terence304/eeg/README.md

# This is a EEG(electroencephalogram) project of Altium Designer PCB layout
