terence304/eeg/Documentation/BOM.xlsx

Sheet: Part List Report
 | Component list |  |  |  | Bill of Materials For PCB Document [PCB3.PcbDoc]
 | Source Data From: | PCB3.PcbDoc |  |  |  | Contact:
 | Project: | Final_Project_Layout.PrjPcb |  |  |  | NYU
 | Variant: | None |  | Chung-Ying Huang | cyh316@nyu.edu | Your group number : 19
 |  |  |  | Yu-Yang Lin | yyl289@nyu.edu | your email
 | Report Date: | 11/10/2014 | 2:04:17 PM
 | Print Date: | 2014-11-10 | 16:44:28
# | #Column Name Error:Category | Designator | #Column Name Error:Manufacturer | #Column Name Error:Manufacturer Part Number | #Column Name Error:Package / Case | LibRef | Quantity | #Column Name Error:Supplier 1 | #Column Name Error:Supplier Part Number 1 | #Column Name Error:Supplier Order Qty 1 | #Column Name Error:Supplier Stock 1 | #Column Name Error:Supplier Unit Price 1 | #Column Name Error:Supplier Subtotal 1 | #Column Name Error:Supplier Currency 1
1 |  | B1 |  |  |  | BatteryHolder_CR123A | 1
 |  | c1,c3,c4,c12,c17 |  |  |  | 2.2u, Capacitor | 5
 |  | c2,c5,c6,c7,c10,c11,c13,c16 |  |  |  | 0.1u, Capacitor | 8
 |  | c8 |  |  |  | 470p, Capacitor | 1
 |  | c9,c18 |  |  |  | 10u, Capacitor | 2
 |  | c14 |  |  |  | 10n, Capacitor | 1
 |  | c15,c19 |  |  |  | 2.2n, Capacitor | 2
8 |  | CH1, CH2, REF, RL1 |  |  |  | Jack_36619_3pins | 4
9 |  | O1, O2, O3, O4 |  |  |  | OPA2347_SOIC8 | 4
10 |  | Q1 |  |  |  | Connector_20021121_10pins | 1
 |  | R1,R2,R3,R11,R13,R16,R18 |  |  |  | 1.3meg, Reistor | 7
 |  | R4, R8 |  |  |  | 10k, Reistor | 2
 |  | R5,R6,R10,R15 |  |  |  | 7.5k, Resistor | 4
 |  | R7 |  |  |  | 470k, Resistor | 1
 |  | R9,R12 |  |  |  | 1meg, Resistor | 2
 |  | R14,R16 |  |  |  | 16k, Resistor | 2
17 |  | U1 |  |  |  | INA2126_DIP16 | 1
 |  |  |  |  |  |  | 48 |  |  | 0 |  |  | 0
Approved |  |  |  |  | Notes
 |  |  |  |  |  |  | 1 | pcs: | Total |  | 0 |  | <none>
 |  |  |  |  |  |  |  |  | Price for 1pcs |  | 0.00 |  | <none>

Sheet: Project Information
Project Full Path | C:\Users\Public\Documents\Altium\Projects\Final_Project_Layout2\Final_Project_Layout.PrjPcb
Project Filename | Final_Project_Layout.PrjPcb
Variant Name | None
Data-Source Filename | PCB3.PcbDoc
Data-Source Full Path | C:\Users\Public\Documents\Altium\Projects\Final_Project_Layout2\PCB3.PcbDoc
Title | Bill of Materials For PCB Document [PCB3.PcbDoc]
Total Quantity | 48
Report Time | 2:04:17 PM
Report Date | 11/10/2014
Report Date & Tine | 11/10/2014 2:04:17 PM
Output Name | Bill of Materials
Output Type | BOM_PartType
Output Generator Name | BOM
Output Generator Description | Bill of Materials
