terence304/eeg/Documentation/Final_Project.PDF

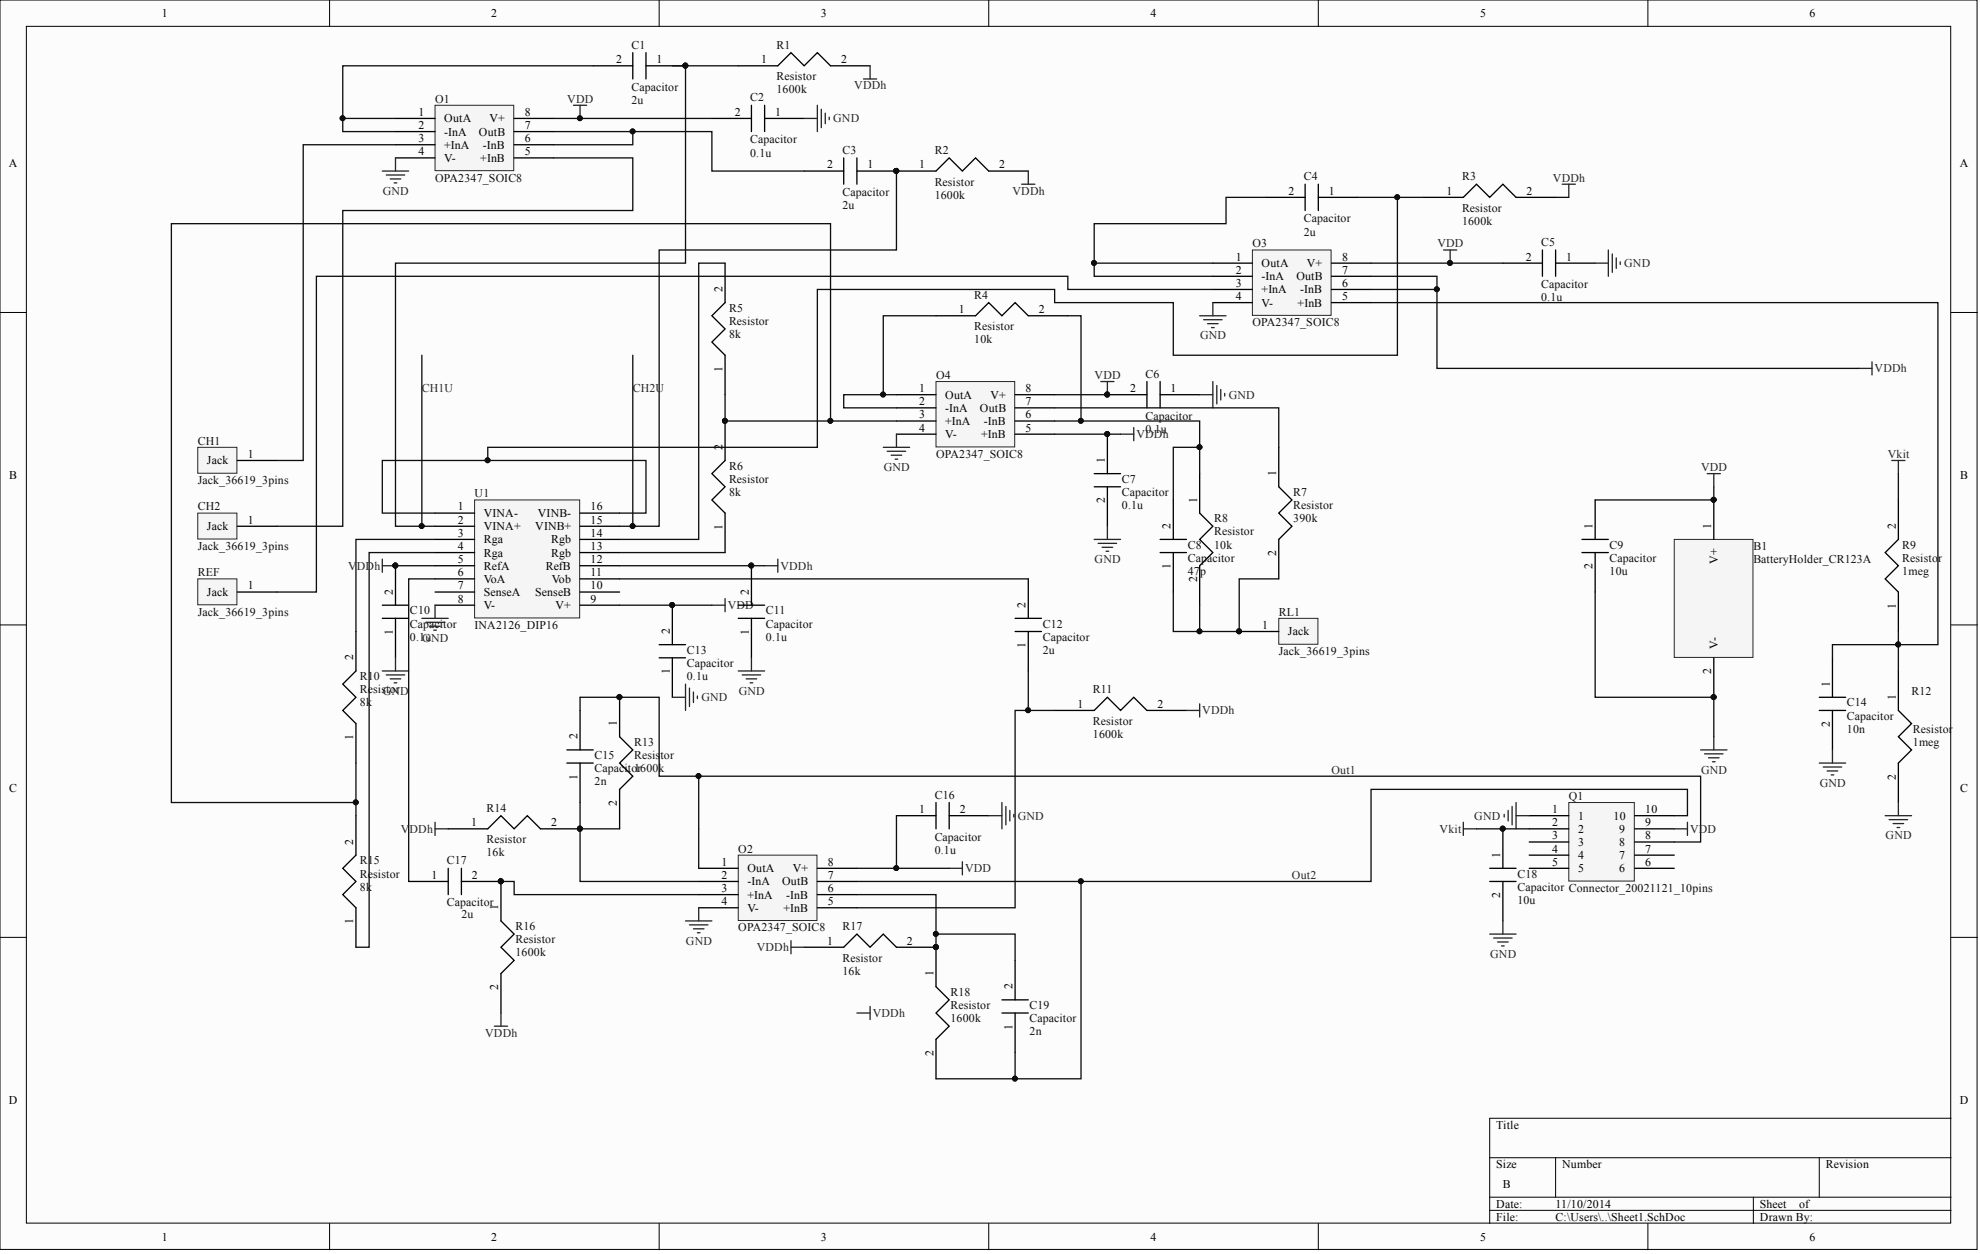
[picture p13: page 1]

O3 | Capacitor

OutA 1

Vkit

RefA 5
VoA 6

R10 Resistor | 0.1u

C15 Capacitor | R13 Resistor 1600k

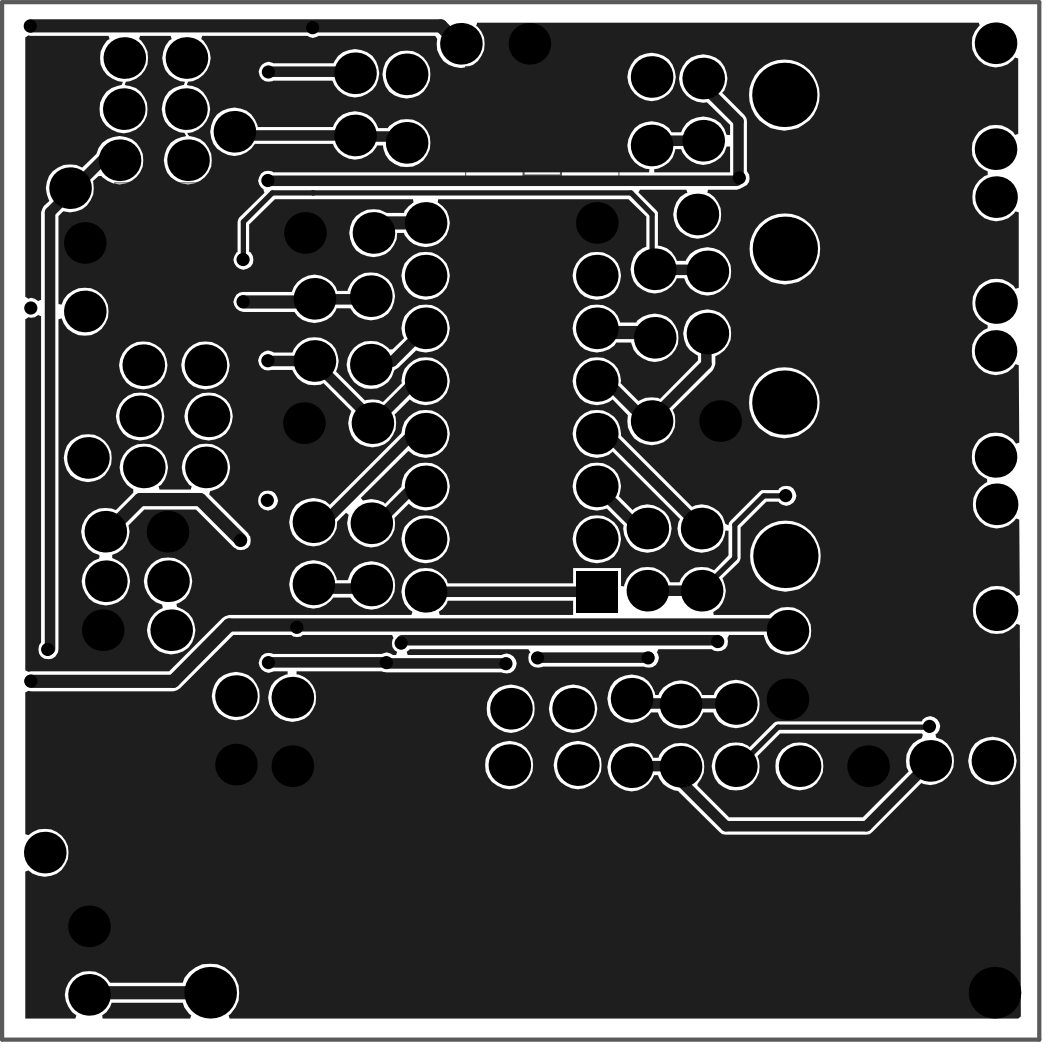
[picture p14: page 2]

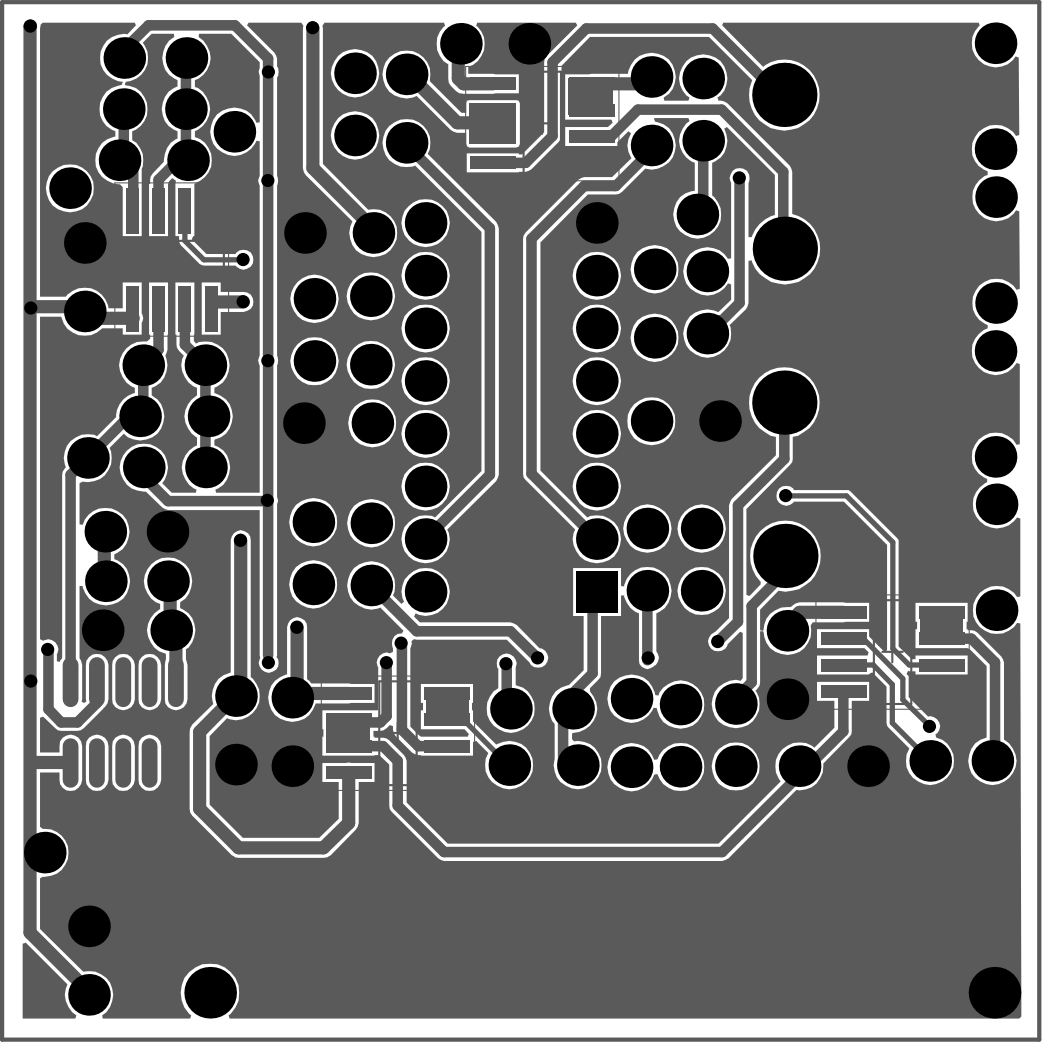
[picture p15: page 3]

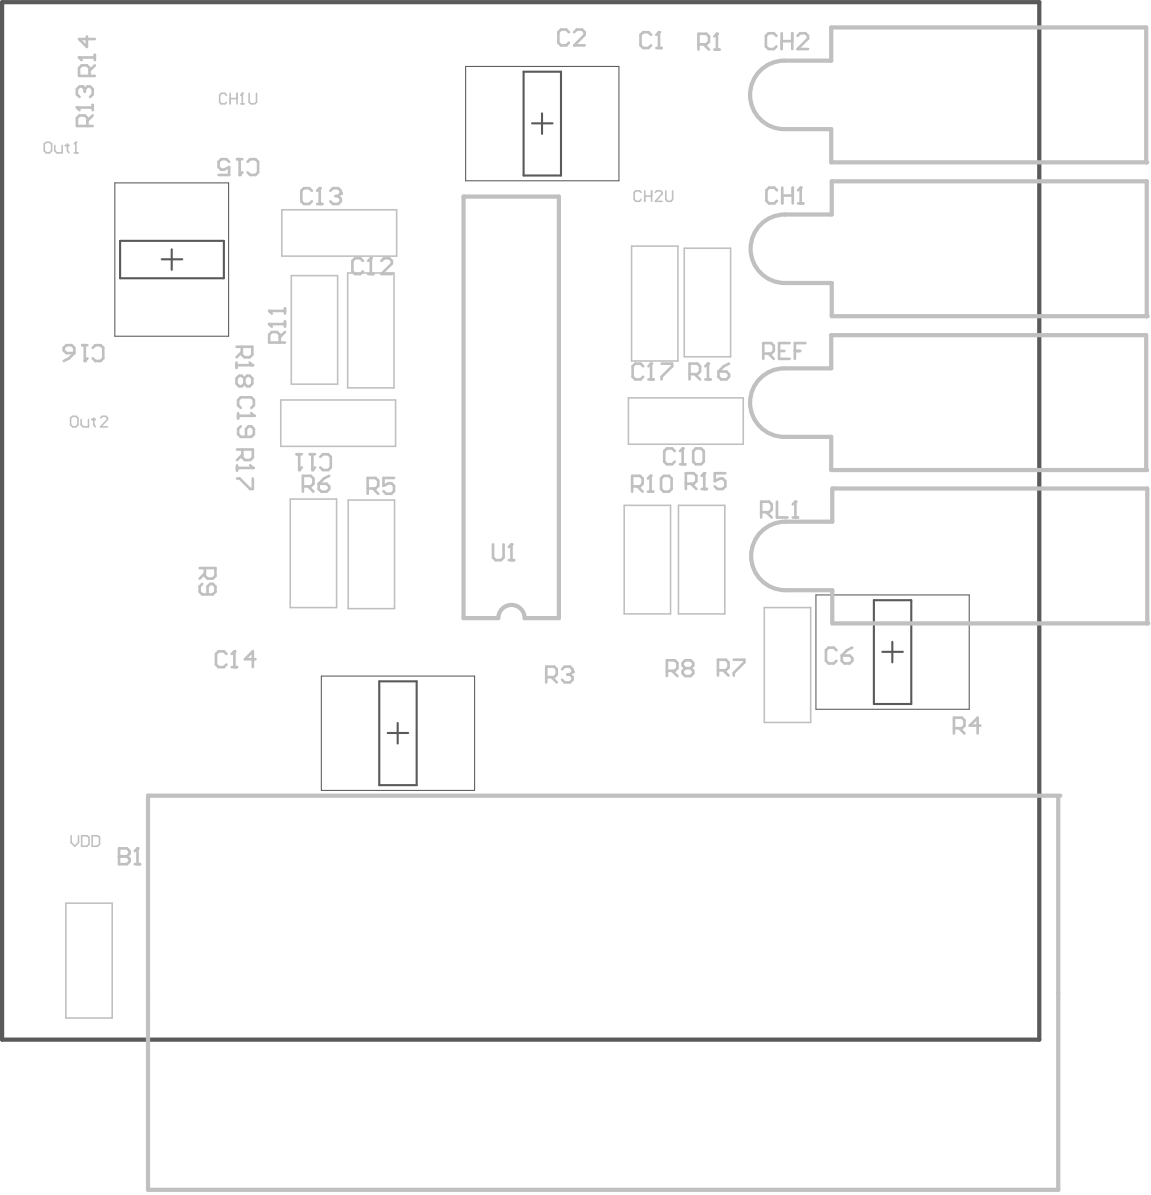
[picture p16: page 4]

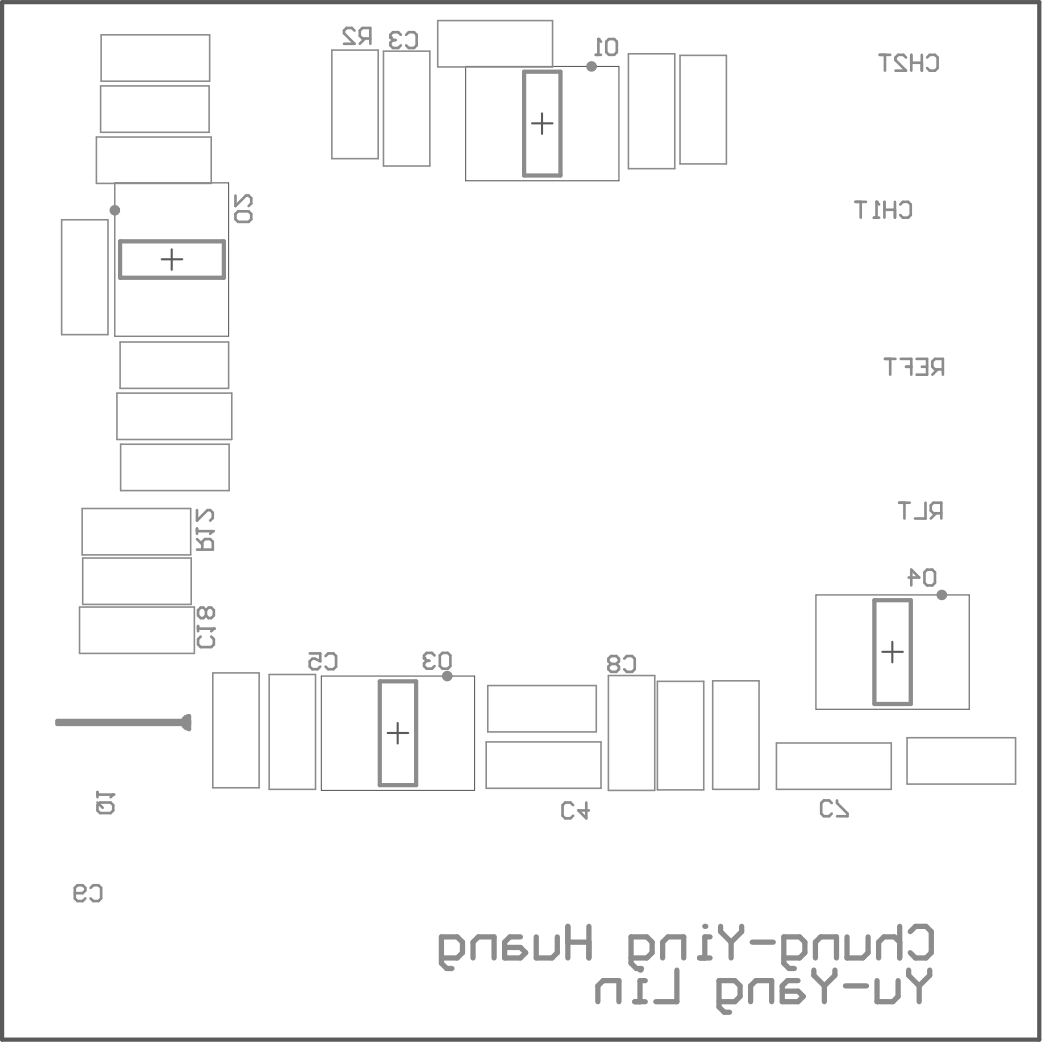
[picture p17: page 5]

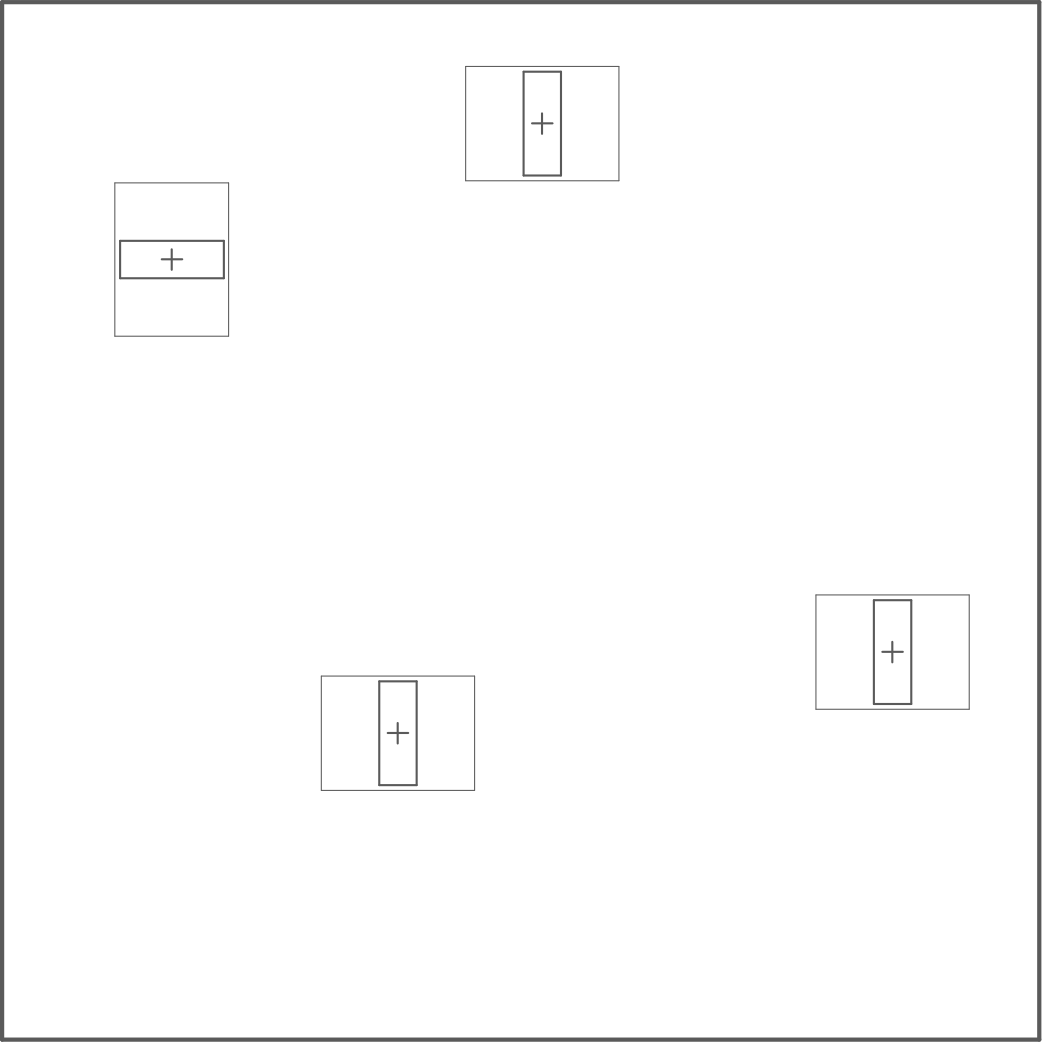
[picture p18: page 6]

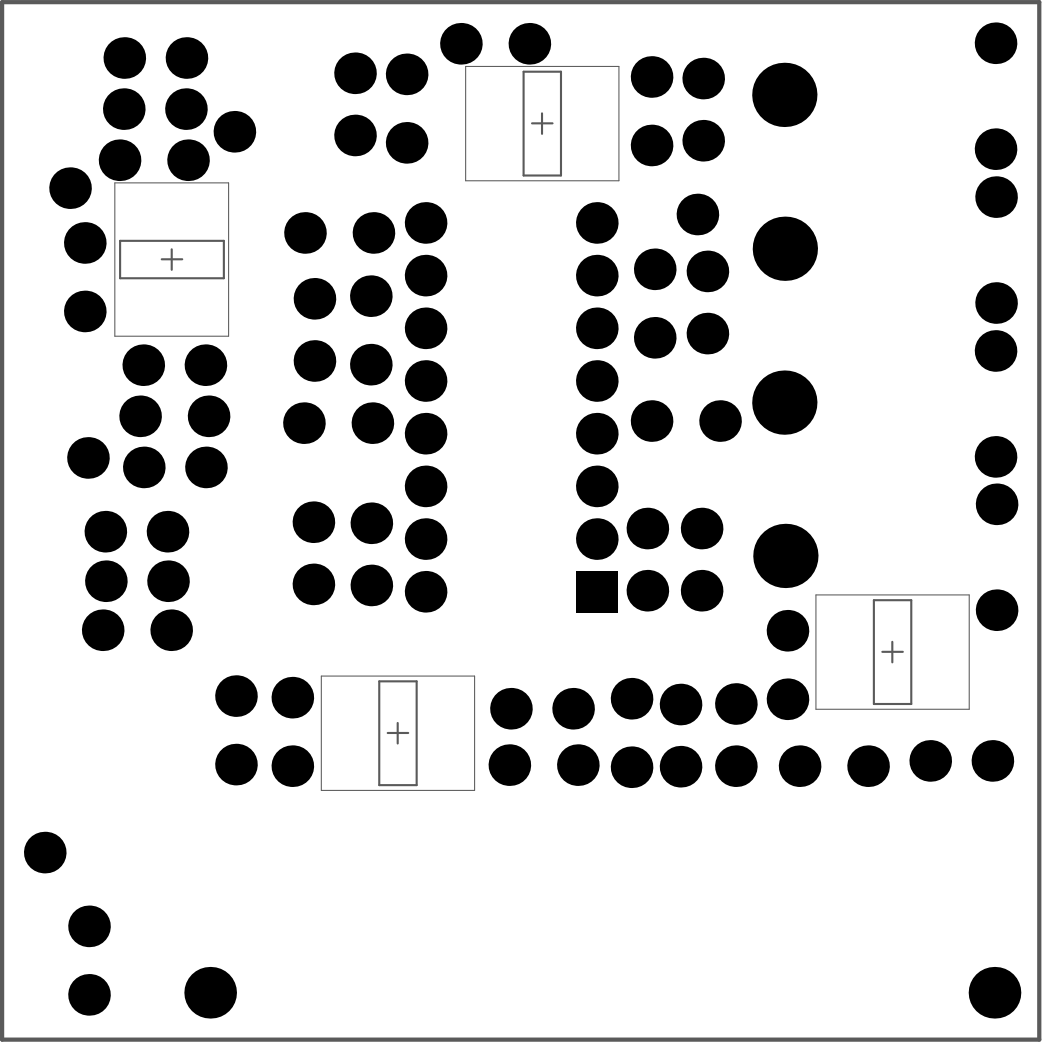
[picture p19: page 9]

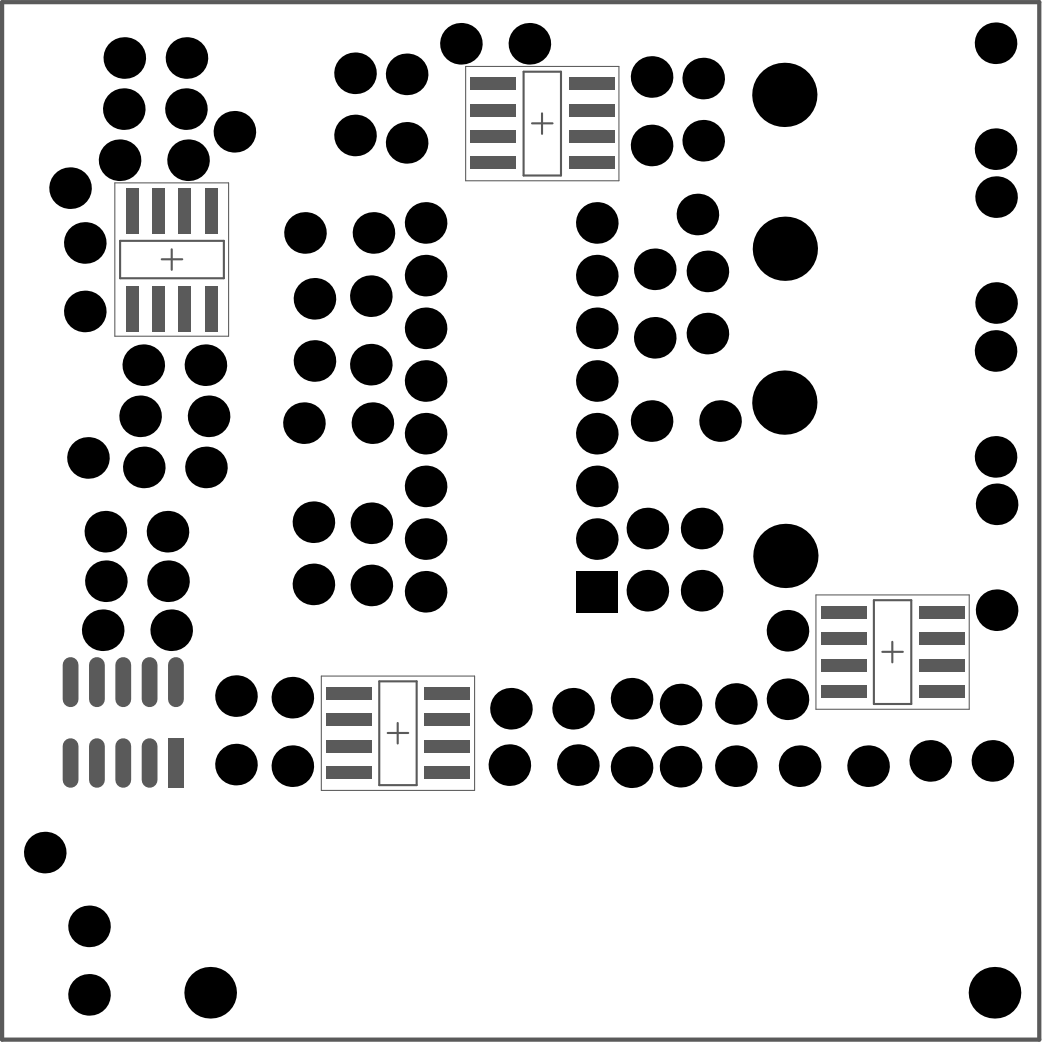
[picture p20: page 10]

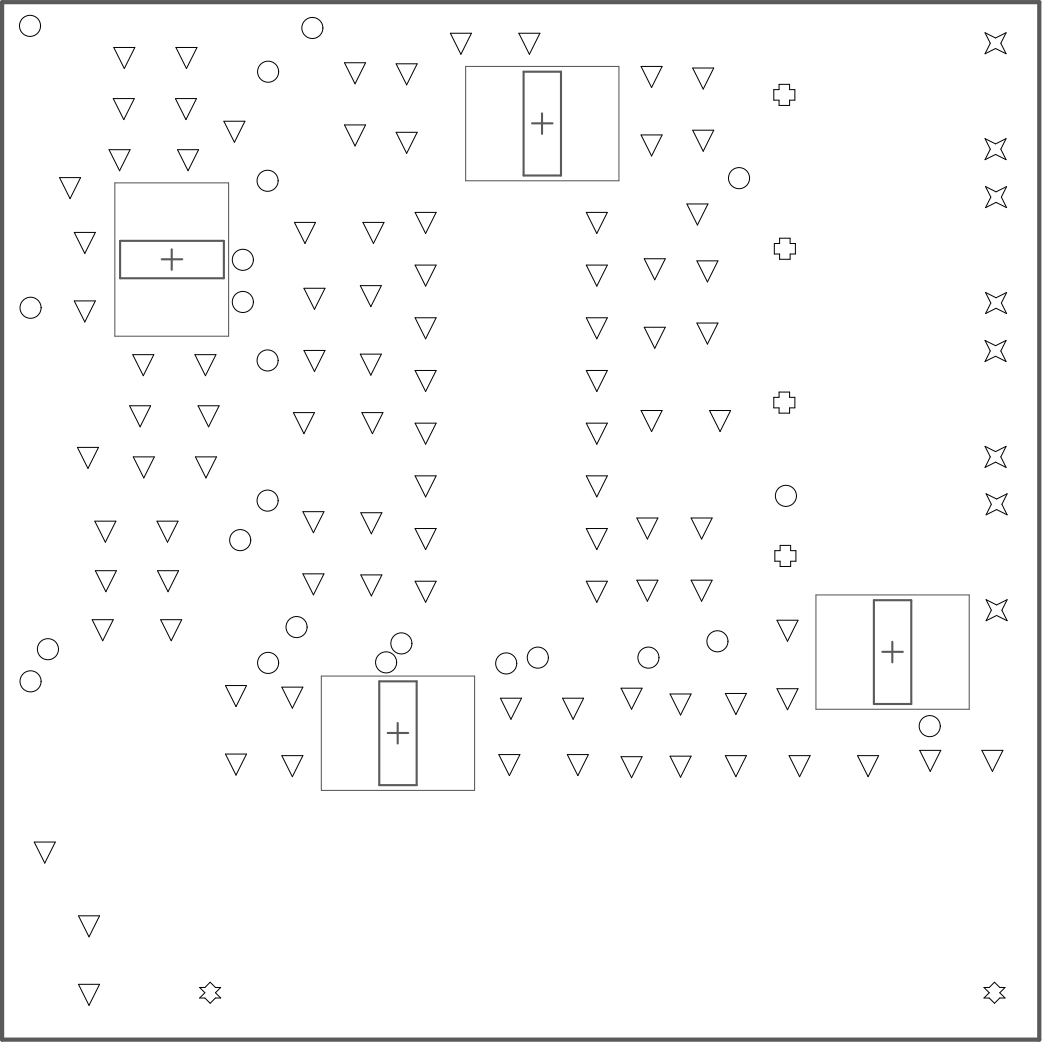
[picture p21: page 11]

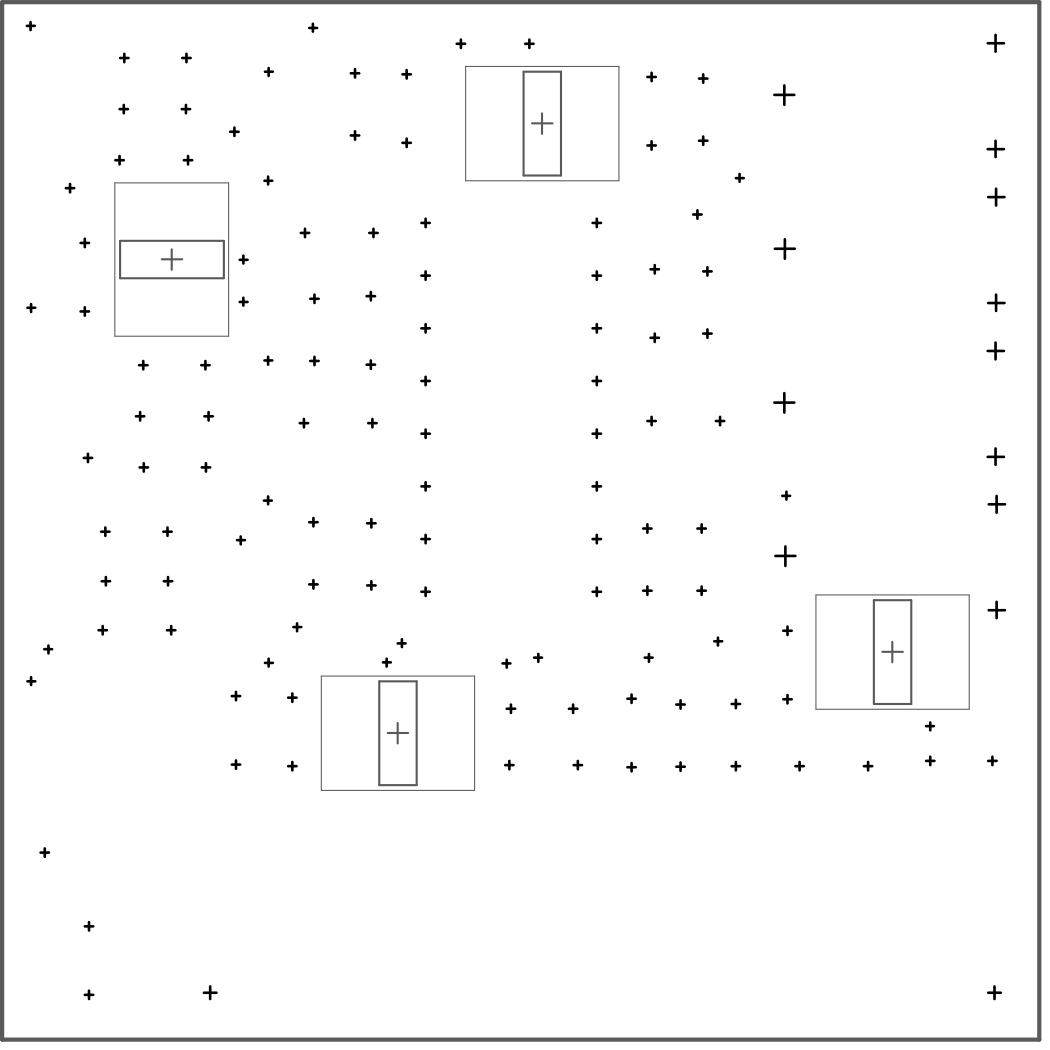
[picture p22: page 12]
