terence304/eeg/(list of files, drawings)

Other design files:
Final_Project_Layout.PrjPcb
layout.PcbDoc
Sheet1.SchDoc
